modularizer/weargaroo/assets/pcb-1.png

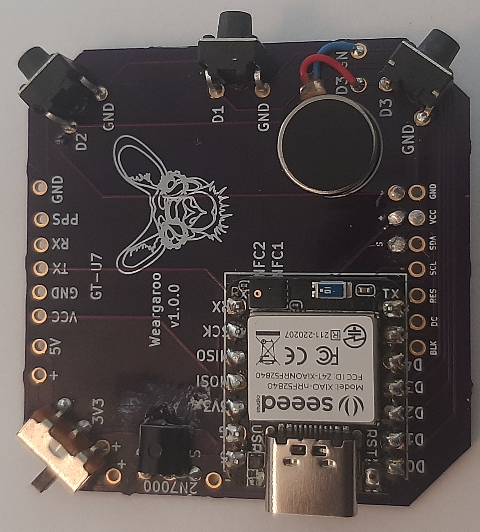
assets/pcb-1.png
