modularizer/weargaroo/assets/watch.png

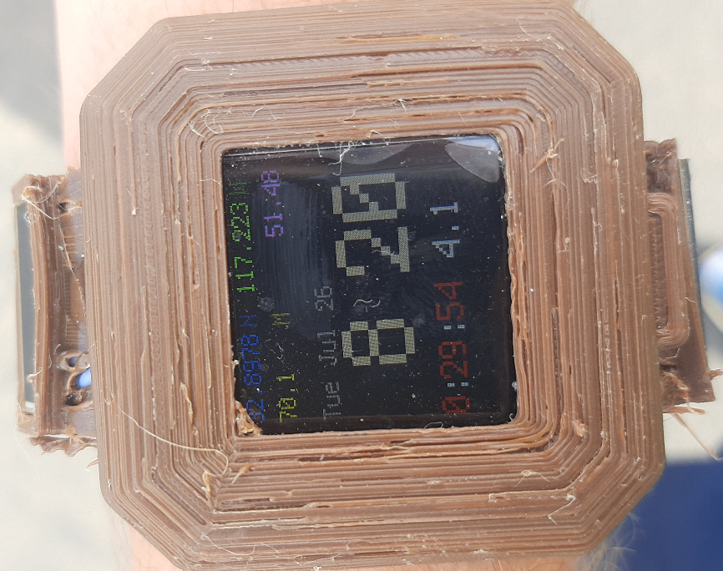
assets/watch.png
