modularizer/weargaroo/(commit log)

2022-07-03 added gmt offset calibration
2022-07-14 fixed time calibration
